hhautomatizacion/lavadora.net/README.md

<br/>
<p align="center">
  
</p>
<br/>

# Lavadora.Net

## Fecha
* 2014-03

## Descripcion del proyecto
* Control de lavadora industrial Tonello 420ls

## Herramientas utilizadas
* Visual Basic 2005
* KGL_WIN version 3.66

## Modelos de PLC, etc.
* PLC LS Master K 120S K7M-DR40U
* Modulo Analogo G7F-R2D 

## Autores
* <a href="http://www.github.com/pedrohermon">pedrohermon</a> 
* <a href="http://www.github.com/emmanuel156">emmanuel156</a> 

## Comentarios
* Ninguno

## Contenido
* Carpeta de Diagramas
	* Diagramas del proyecto
		* Diagramas electricos
		* Diagramas de bloques
		* Dibujos
* Carpeta de Documentos
	* Documentos pensados para el usuario final
		* Manuales de usuario
		* Manuales de programacion
* Carpeta de Fotos
	* Fotos del proyecto antes, durante y despues del desarrollo del mismo
		* Fotos
		* Capturas de pantalla
* Carpeta de Historial
	* Documentacion del desarrollo del proyecto
		* Hojas de datos de componentes
		* Manuales de usuario de componentes
		* Documentacion de funciones, herramientas
* Carpeta de Programas
	* Programas de Computadora, PLC, etc. 
		* Codigos fuente
		* Iconos e imagenes usados en los programas.
		* Archivos de configuracion de los programas
		* Programas compilados
* Carpeta de Pruebas
	* Pruebas preliminares del proyecto
		* Programas incompletos, o secciones de programas
		* Capturas de comunicacion
		* Modelos de componentes que se hayan probado

---
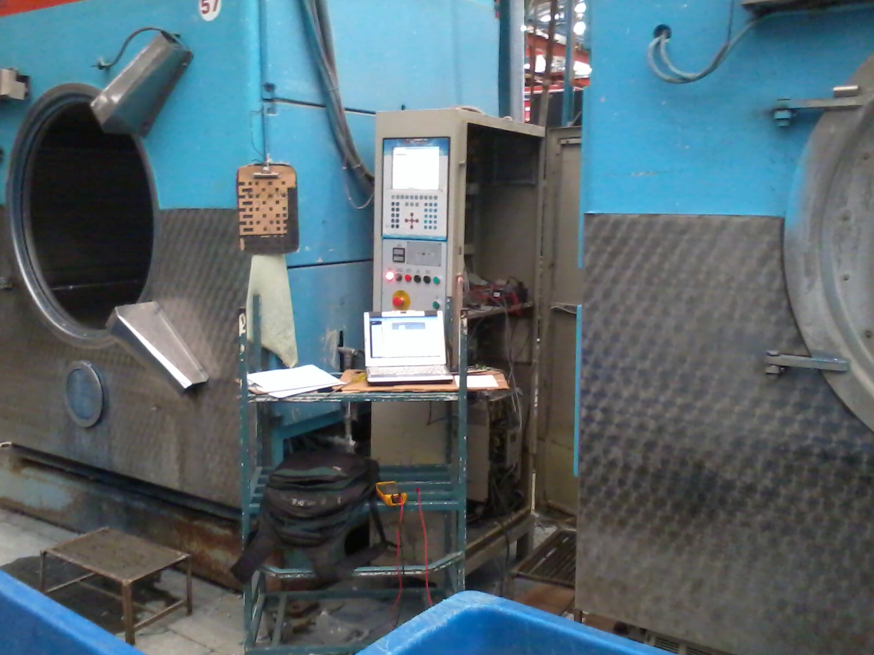
[picture p1: Fotos/2014-03-02 08.20.04.jpg]
2014-03-02 08.20.04.jpg

---
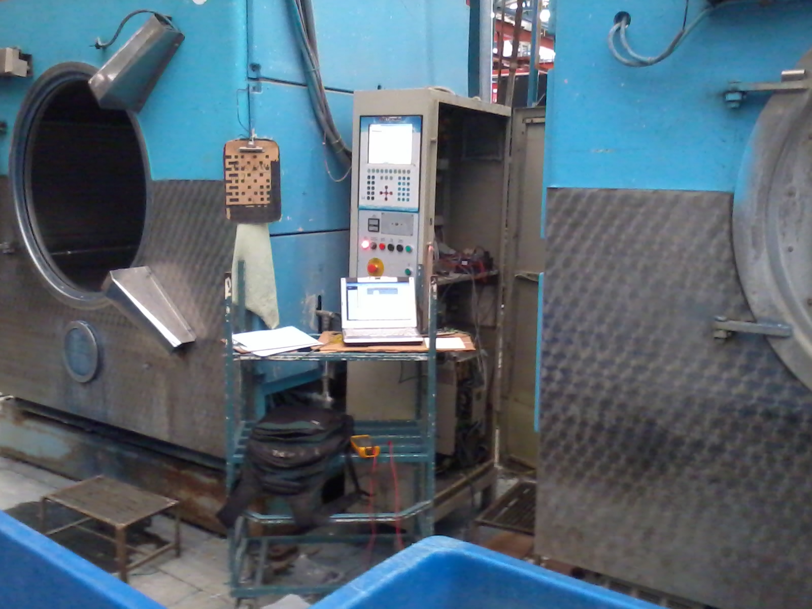
[picture p2: Fotos/2014-03-02 08.20.07.jpg]
2014-03-02 08.20.07.jpg

---
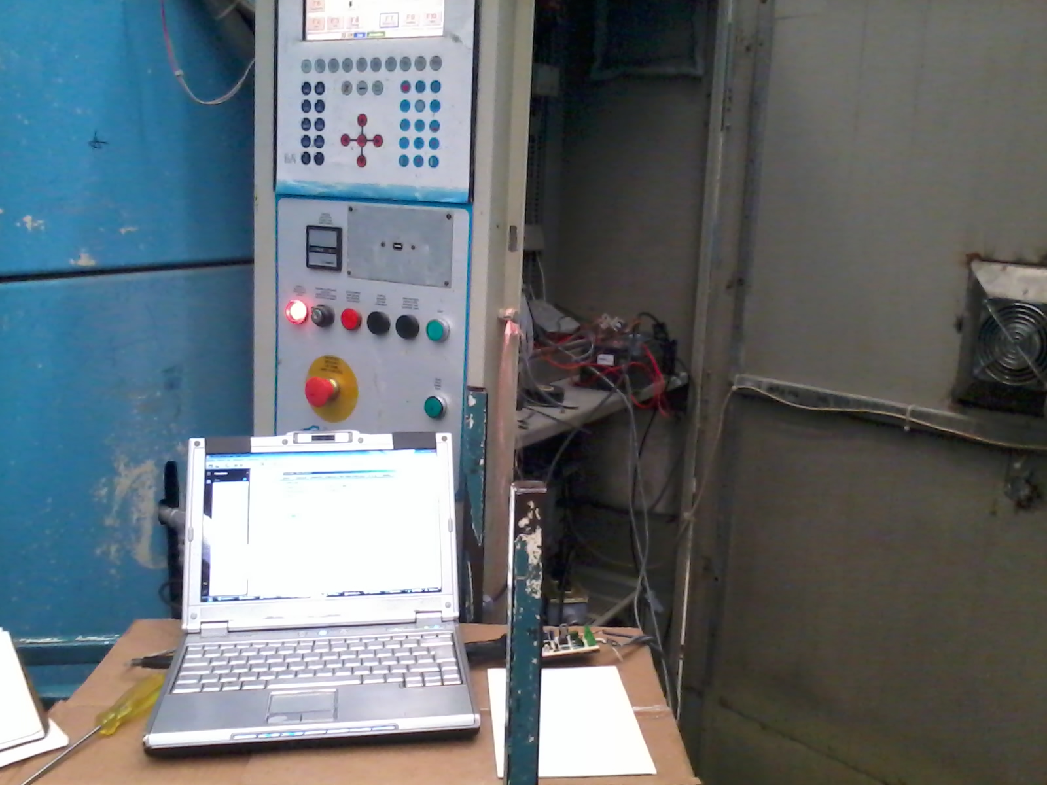
[picture p3: Fotos/2014-03-02 08.20.22.jpg]
2014-03-02 08.20.22.jpg

---
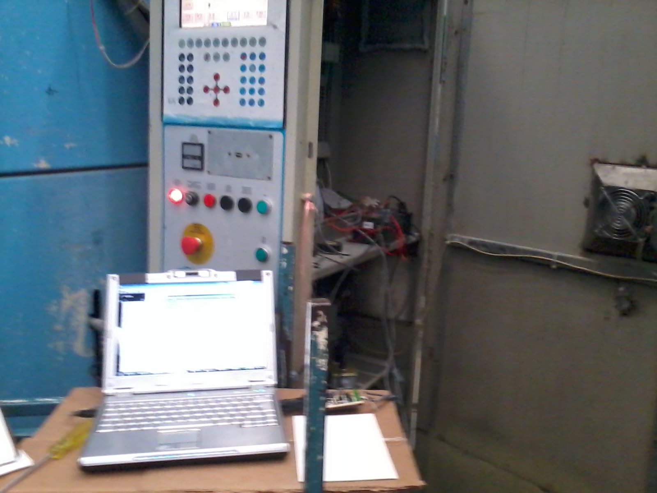
[picture p4: Fotos/2014-03-02 08.20.28.jpg]
2014-03-02 08.20.28.jpg

---
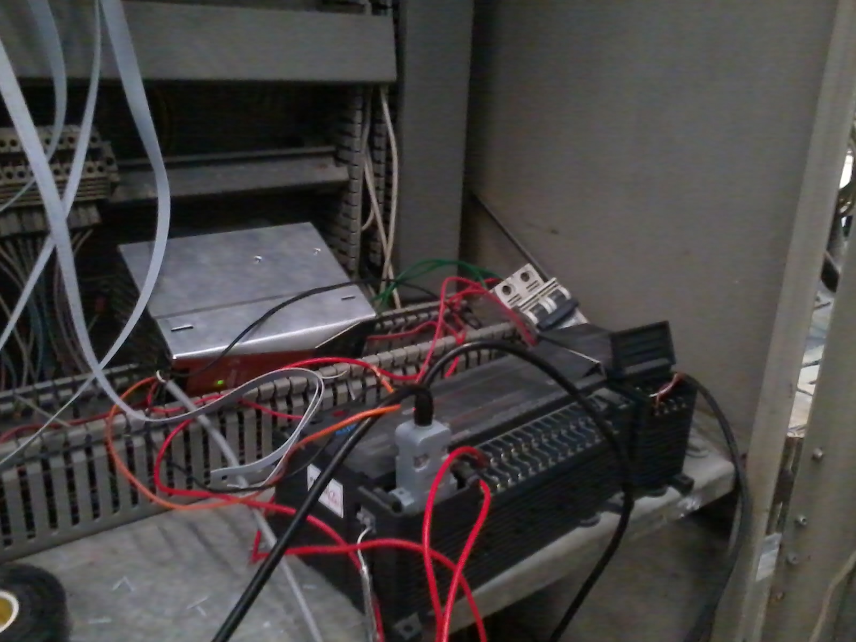
[picture p5: Fotos/2014-03-02 08.20.47.jpg]
2014-03-02 08.20.47.jpg

---
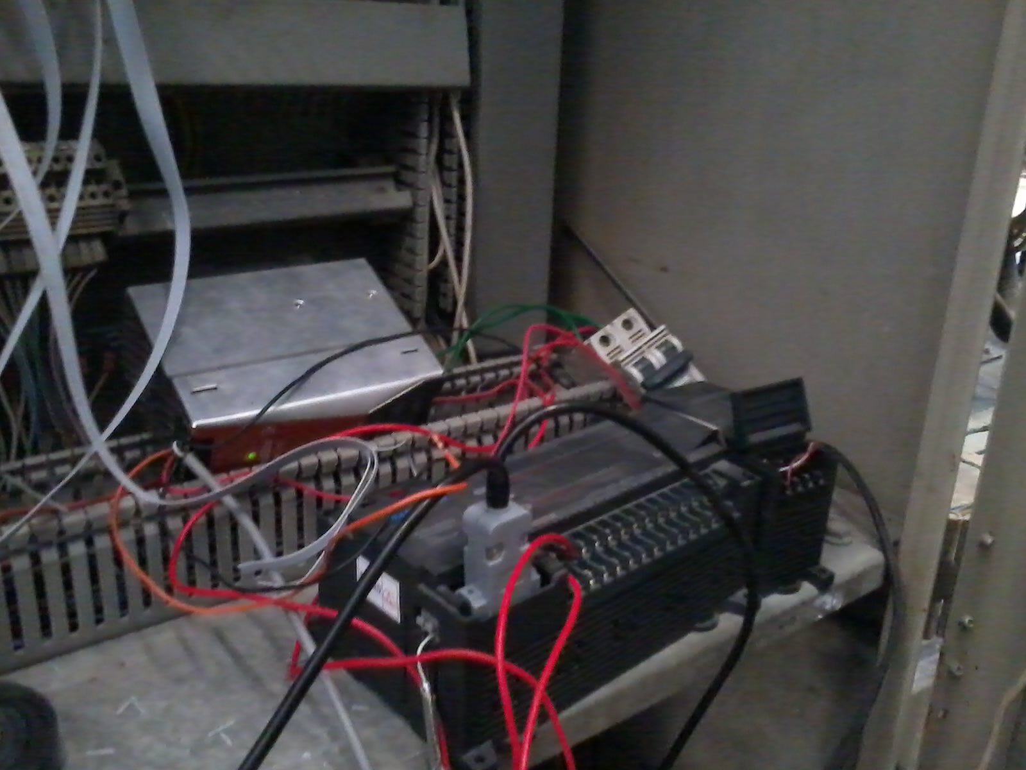
[picture p6: Fotos/2014-03-02 08.20.51.jpg]
2014-03-02 08.20.51.jpg

---
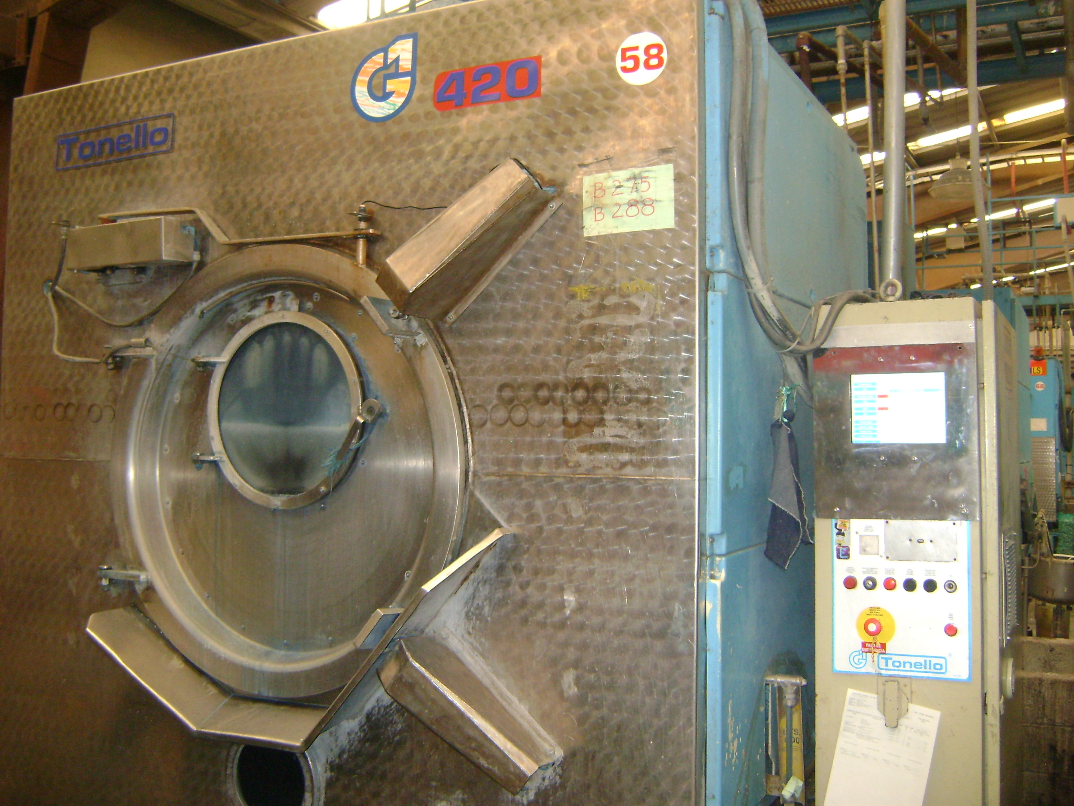
[picture p7: Fotos/DSC03446.JPG]

---
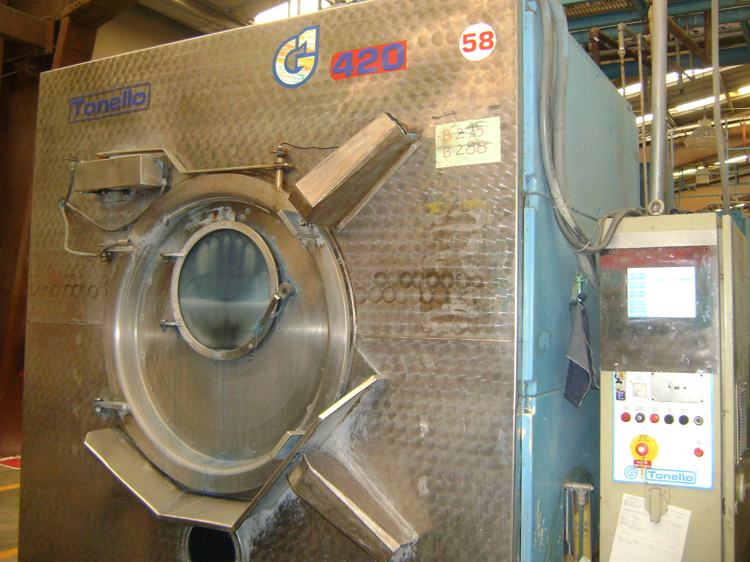
[picture p8: Fotos/DSC03447.JPG]

---
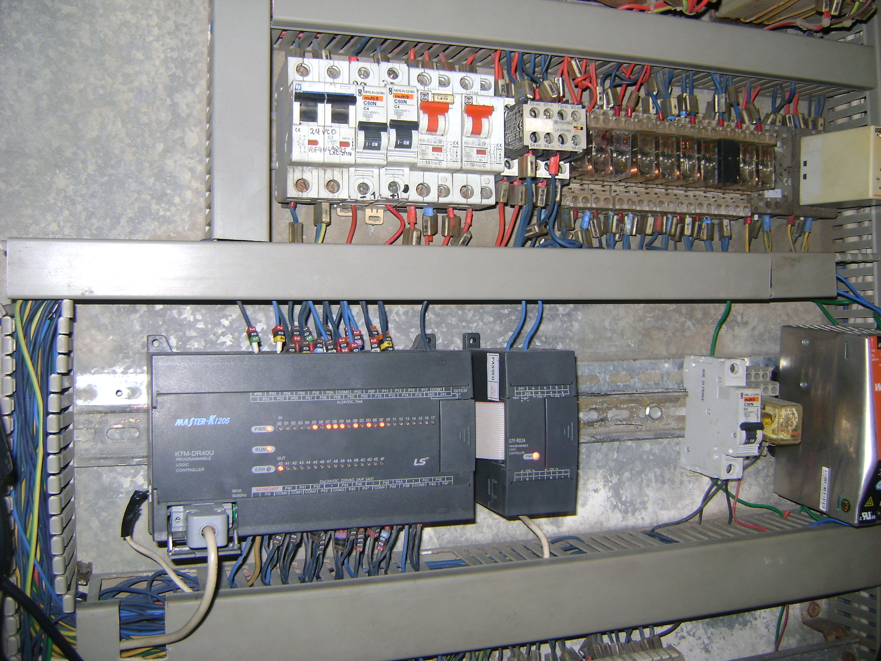
[picture p9: Fotos/DSC03448.JPG]

---
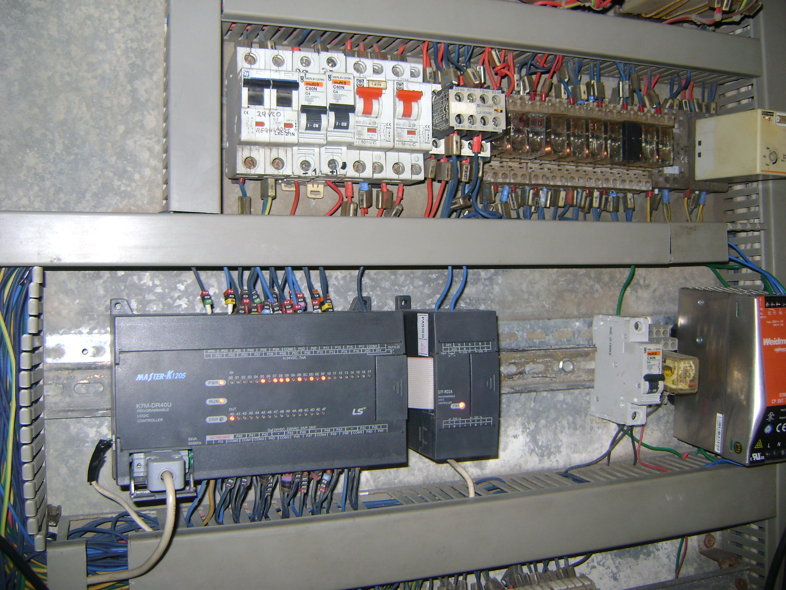
[picture p10: Fotos/DSC03449.JPG]

---
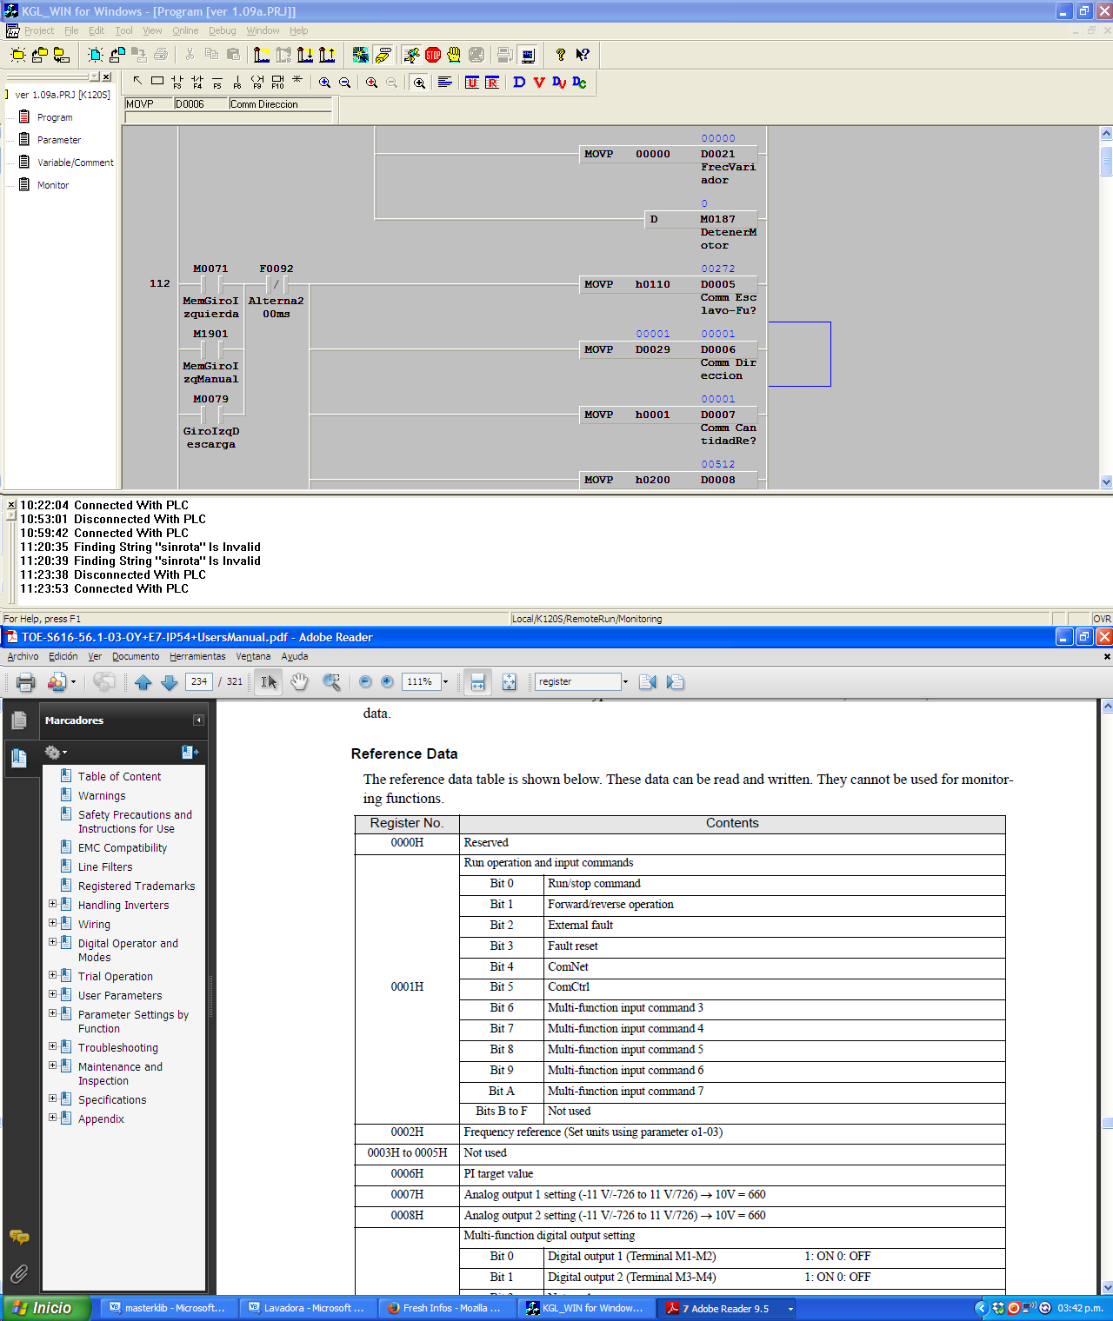
[picture p11: Historial/Captura de pantalla 2015-06-18 15.42.06.png]
Captura de pantalla 2015-06-18 15.42.06.png

---

---

---

---

---

---

---

---

---

---

---

---

---

---

---

---

---

---

---

---

---

---

---

---

---

---

---

---

---

---
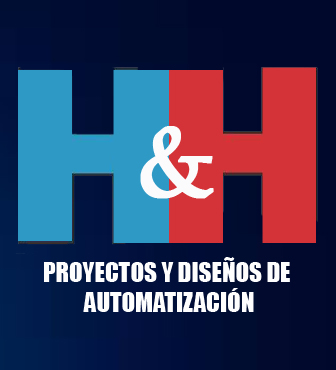
[picture p12: Programas/Lavadora/Iconos/logo.jpg]

---

---

---

---

---

---

---

---

---

---

---

---

---

---

---

---

---

---

---

---

---

---

---

---

---

---

---

---

---

---

---

---

---

---

---

---

---

---

---
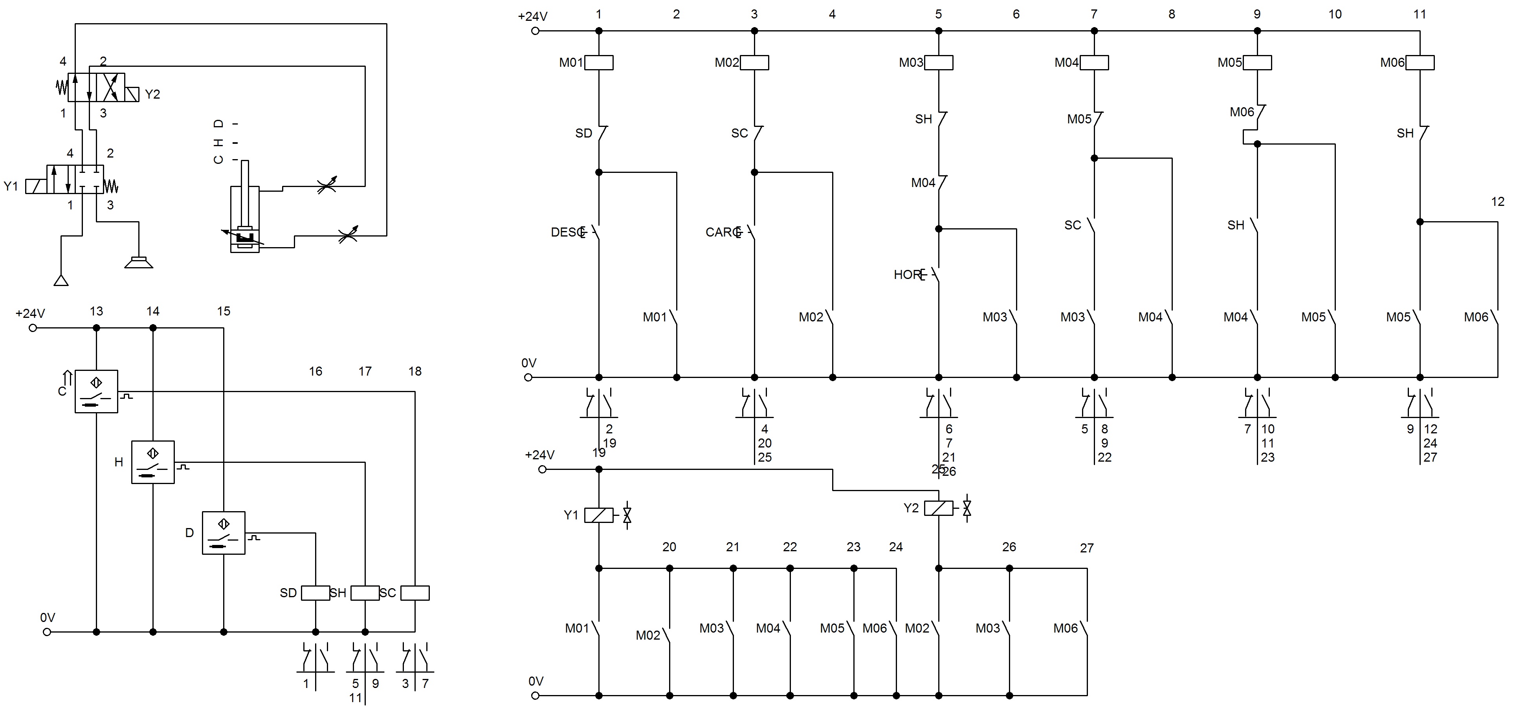
[picture p13: Pruebas/volqueteo.jpg]

---
