hhautomatizacion/lavadora.net/Documentos/Checklist.docx

# Checklist

Conexiones de PC

- Revisar conexión fuente de alimentación PC
- Revisar conexión fuente de alimentación Pantalla Touch
- Revisar cable de comunicación PC a PLC
- Revisar cable de conexión PC a Pantalla Touch

Conexiones de PLC

- Alimentación de 220v correctamente atornillada
- Sentido de giro de motor
- Revisar accionamiento final de carrera arriba
- Revisar accionamiento final de carrera horizontal
- Revisar accionamiento final de carrera abajo
- Revisar accionamiento Bomba Hidráulica
- Revisar accionamiento Pistón Desagüe
- Revisar accionamiento Válvula Agua fría
- Revisar accionamiento Válvula Agua caliente
- Revisar accionamiento Válvula Agua tratada
- Revisar accionamiento Válvula Vapor
- Revisar accionamiento Bomba cubeta de químicos

Programación PC

- Revisar activación de Windows
- Revisar arranque automático del programa
- Revisar parámetros de funcionamiento
- Revisar apagado automático al salir del programa
