hhautomatizacion/lavadora.net/Diagramas/entradas y salidas plc.xlsx

Entradas |  |  | Salidas
P00 | 205 | Cuentalitros * | P40 | 1001 | Start
P04 | 204 | Sensor cesto | P41 | 1003 | Desague
P05 | 101 | Paro de emergencia | P42 | 1004 | Agua fria
P06 | 102 | Start | P43 | 1005 | Agua caliente o tratada
P07 | 104 | Termico motor | P44 | 1006 | Agua zuavizada
P08 | 105 | Alarma inversor | P45 | 1007 | Vapor
P09 | 106 | Velocidad minima | P46 | 1008 | Abrir puerta
P0A | 107 | Puerta abierta | P47 | 2001 | Cerrar puerta
P0B | 108 | Puerta cerrada | P48 | 2002 | Seguros puerta
P0C | 202 | Sonda nivel medio | P49 | 2006 | Bajar maquina
P0D | 203 | Sonda nivel bajo | P4A | 3001 | Bomba cubeta
P0E | 206 | Maquina arriba | P4B | 3002 | Enjuague cubeta
P0F | 207 | Maquina horizontal | P4C | 3005 | Unidad hidraulica
P10 | 208 | Maquina abajo | P4D | 3006 | Torreta
P11 | 303 | Introducir quimicos
P12 | 304 | Enjuague quimicos
P13 | 307 | Nivel bajo quimicos
* Revisar que la conexión a tierra este aterizada en ambos extremos.
PLC | Variador
+ | 40
- | 41
