hhautomatizacion/lavadora.net/Programas/parametros.xlsx

Sheet: ton420ls
Registro | Descripcion | Valor
D750 | CentVel1Acel | 6000
D752 | CentVel2Acel | 12000
D754 | CentVel3Acel | 18000
D756 | CentVel4Acel | 21500
D760 | CentAcel1Acel | 1000
D762 | CentAcel2Acel | 500
D764 | CentAcel3Acel | 100
D766 | CentAcel4Acel | 50
D770 | CentVel1Freno | 21500
D772 | CentVel2Freno | 18000
D774 | CentVel3Freno | 12000
D776 | CentVel4Freno | 6000
D780 | CentAcel1Freno | 20
D782 | CentAcel2Freno | 150
D784 | CentAcel3Freno | 750
D786 | CentAcel4Freno | 1500
K100 | DeshabilitaVolquete | 1
 | RegistroControl | 0
 | RPMa60Hz | 50
 | FrecMaxima | 225
 | VelDescarga | 500
 | TiempoDescarga | 20
 | VelDespedrado | 400
 | AceleracionRotacion | 10
 | Multiplo | 10
 | Divisor | 1
 | OffsetLlenado | 2
 | NivelMinCalentamiento | 100
 | SopleteoSondas | 5
 | IntroAditivos | 10
 | EnjuagueAditivos | 5
 | DwelltimeVolquete | 1
 | MaximoTiempoVolquete | 60

Sheet: ton50ls
Registro | Descripcion | Valor
D750 | CentVel1Acel | 2000
D752 | CentVel2Acel | 4000
D754 | CentVel3Acel | 6000
D756 | CentVel4Acel | 8000
D760 | CentAcel1Acel | 10
D762 | CentAcel2Acel | 15
D764 | CentAcel3Acel | 10
D766 | CentAcel4Acel | 5
D770 | CentVel1Freno | 8000
D772 | CentVel2Freno | 6000
D774 | CentVel3Freno | 2000
D776 | CentVel4Freno | 1000
D780 | CentAcel1Freno | 10
D782 | CentAcel2Freno | 15
D784 | CentAcel3Freno | 10
D786 | CentAcel4Freno | 5
K100 | DeshabilitaVolquete | 1
 | RegistroControl | 0
 | RPMa60Hz | 300
 | FrecMaxima | 94
 | VelDescarga | 500
 | TiempoDescarga | 20
 | VelDespedrado | 400
 | AceleracionRotacion | 10
 | Multiplo | 1
 | Divisor | 1
 | OffsetLlenado | 2
 | NivelMinCalentamiento | 10
 | SopleteoSondas | 5
 | IntroAditivos | 10
 | EnjuagueAditivos | 5
 | DwelltimeVolquete | 1
 | MaximoTiempoVolquete | 60
