hhautomatizacion/lavadora.net/(list of files, cad)

Other CAD files:
Diagramas/Modificacion lavadora Tonello 420LS.dwg
Pruebas/simula-lavadora/simula lavadora.dwg
