hhautomatizacion/lavadora.net/Pruebas/README.md

<br/>
<p align="center">
  
</p>
<br/>

# Carpeta de Pruebas

## Pruebas preliminares del proyecto

* Programas incompletos, o secciones de programas

* Capturas de comunicacion

* Modelos de componentes que se hayan probado

---

---
