hhautomatizacion/lavadora.net/Pruebas/frecuencias 420ls.xlsx

Sheet: 20180418205009
2018-04-18T20:50:10.634213 | 1 | 3 | 2 | 1 | 92 | 185 | 237
2018-04-18T20:50:10.735077 | 1 | 3 | 2 | 1 | 92 | 185 | 237
2018-04-18T20:50:10.835950 | 1 | 3 | 2 | 1 | 92 | 185 | 237
2018-04-18T20:50:11.039070 | 1 | 3 | 2 | 1 | 94 | 56 | 44
2018-04-18T20:50:11.139814 | 1 | 3 | 2 | 1 | 94 | 56 | 44
2018-04-18T20:50:11.239197 | 1 | 3 | 2 | 1 | 95 | 249 | 236
2018-04-18T20:50:11.338816 | 1 | 3 | 2 | 1 | 95 | 249 | 236
2018-04-18T20:50:11.440816 | 1 | 3 | 2 | 1 | 94 | 56 | 44
2018-04-18T20:50:11.843694 | 1 | 3 | 2 | 1 | 92 | 185 | 237
2018-04-18T20:50:11.945697 | 1 | 3 | 2 | 1 | 92 | 185 | 237
2018-04-18T20:50:12.045073 | 1 | 3 | 2 | 1 | 90 | 57 | 239
2018-04-18T20:50:12.145820 | 1 | 3 | 2 | 1 | 91 | 248 | 47
2018-04-18T20:50:12.449318 | 1 | 3 | 2 | 1 | 92 | 185 | 237
2018-04-18T20:50:12.549942 | 1 | 3 | 2 | 1 | 94 | 56 | 44
2018-04-18T20:50:12.649566 | 1 | 3 | 2 | 1 | 93 | 120 | 45
2018-04-18T20:50:12.749066 | 1 | 3 | 2 | 1 | 94 | 56 | 44
2018-04-18T20:50:12.851239 | 1 | 3 | 2 | 1 | 96 | 185 | 252
2018-04-18T20:50:13.054317 | 1 | 3 | 2 | 1 | 95 | 249 | 236
2018-04-18T20:50:13.153948 | 1 | 3 | 2 | 1 | 95 | 249 | 236
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
