hhautomatizacion/lavadora.net/Pruebas/frecuencias 420mj2.xlsx

Sheet: 20180418024331
2018-04-18T02:43:32.126823 | 1 | 3 | 2 | 0 | 0 | 184 | 68
2018-04-18T02:43:32.832956 | 1 | 3 | 2 | 0 | 0 | 184 | 68
2018-04-18T02:43:33.539447 | 1 | 3 | 2 | 0 | 0 | 184 | 68
2018-04-18T02:43:34.245954 | 1 | 3 | 2 | 0 | 0 | 184 | 68
2018-04-18T02:43:34.952448 | 1 | 3 | 2 | 0 | 0 | 184 | 68
2018-04-18T02:43:35.661078 | 1 | 3 | 2 | 0 | 0 | 184 | 68
2018-04-18T02:43:36.368016 | 1 | 3 | 2 | 0 | 0 | 184 | 68
2018-04-18T02:43:37.074031 | 1 | 3 | 2 | 0 | 0 | 184 | 68
2018-04-18T02:43:37.781709 | 1 | 3 | 2 | 0 | 0 | 184 | 68
2018-04-18T02:43:38.488210 | 1 | 3 | 2 | 0 | 0 | 184 | 68
2018-04-18T02:43:39.194606 | 1 | 3 | 2 | 0 | 0 | 184 | 68
2018-04-18T02:43:39.901587 | 1 | 3 | 2 | 0 | 0 | 184 | 68
2018-04-18T02:43:40.608093 | 1 | 3 | 2 | 0 | 0 | 184 | 68
2018-04-18T02:43:41.314462 | 1 | 3 | 2 | 0 | 0 | 184 | 68
2018-04-18T02:43:42.020457 | 1 | 3 | 2 | 0 | 0 | 184 | 68
2018-04-18T02:43:42.727586 | 1 | 3 | 2 | 0 | 0 | 184 | 68
2018-04-18T02:43:43.432619 | 1 | 3 | 2 | 0 | 0 | 184 | 68
2018-04-18T02:43:44.138985 | 1 | 3 | 2 | 0 | 0 | 184 | 68
2018-04-18T02:43:44.845087 | 1 | 3 | 2 | 0 | 0 | 184 | 68
2018-04-18T02:43:45.550836 | 1 | 3 | 2 | 0 | 0 | 184 | 68
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
