hhautomatizacion/lavadora.net/Pruebas/frecuencias 50ls.xlsx

Sheet: 20190417140326
2019-04-17T14:03:26.694000 | 1 | 3 | 2 | 0 | 0 | 184 | 68
2019-04-17T14:03:26.804000 | 1 | 3 | 2 | 0 | 0 | 184 | 68
2019-04-17T14:03:27.119000 | 1 | 3 | 2 | 0 | 0 | 184 | 68
2019-04-17T14:03:27.463000 | 1 | 3 | 2 | 0 | 0 | 184 | 68
2019-04-17T14:03:28.010000 | 1 | 3 | 2 | 0 | 0 | 184 | 68
2019-04-17T14:03:28.338000 | 1 | 3 | 2 | 0 | 0 | 184 | 68
2019-04-17T14:03:28.775000 | 1 | 3 | 2 | 0 | 0 | 184 | 68
2019-04-17T14:03:29.103000 | 1 | 3 | 2 | 0 | 0 | 184 | 68
2019-04-17T14:03:29.322000 | 1 | 3 | 2 | 0 | 0 | 184 | 68
2019-04-17T14:03:29.650000 | 1 | 3 | 2 | 0 | 0 | 184 | 68
2019-04-17T14:03:29.978000 | 1 | 3 | 2 | 0 | 0 | 184 | 68
2019-04-17T14:03:30.307000 | 1 | 3 | 2 | 0 | 0 | 184 | 68
2019-04-17T14:03:30.525000 | 1 | 3 | 2 | 0 | 0 | 184 | 68
2019-04-17T14:03:31.182000 | 1 | 3 | 2 | 0 | 0 | 184 | 68
2019-04-17T14:03:31.510000 | 1 | 3 | 2 | 0 | 0 | 184 | 68
2019-04-17T14:03:31.838000 | 1 | 3 | 2 | 0 | 0 | 184 | 68
2019-04-17T14:03:31.947000 | 1 | 3 | 2 | 0 | 0 | 184 | 68
2019-04-17T14:03:32.057000 | 1 | 3 | 2 | 0 | 0 | 184 | 68
2019-04-17T14:03:32.385000 | 1 | 3 | 2 | 0 | 0 | 184 | 68
2019-04-17T14:03:32.603000 | 1 | 3 | 2 | 0 | 0 | 184 | 68
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
