hhautomatizacion/lavadora.net/Pruebas/simula-lavadora/simula lavadora.pdf

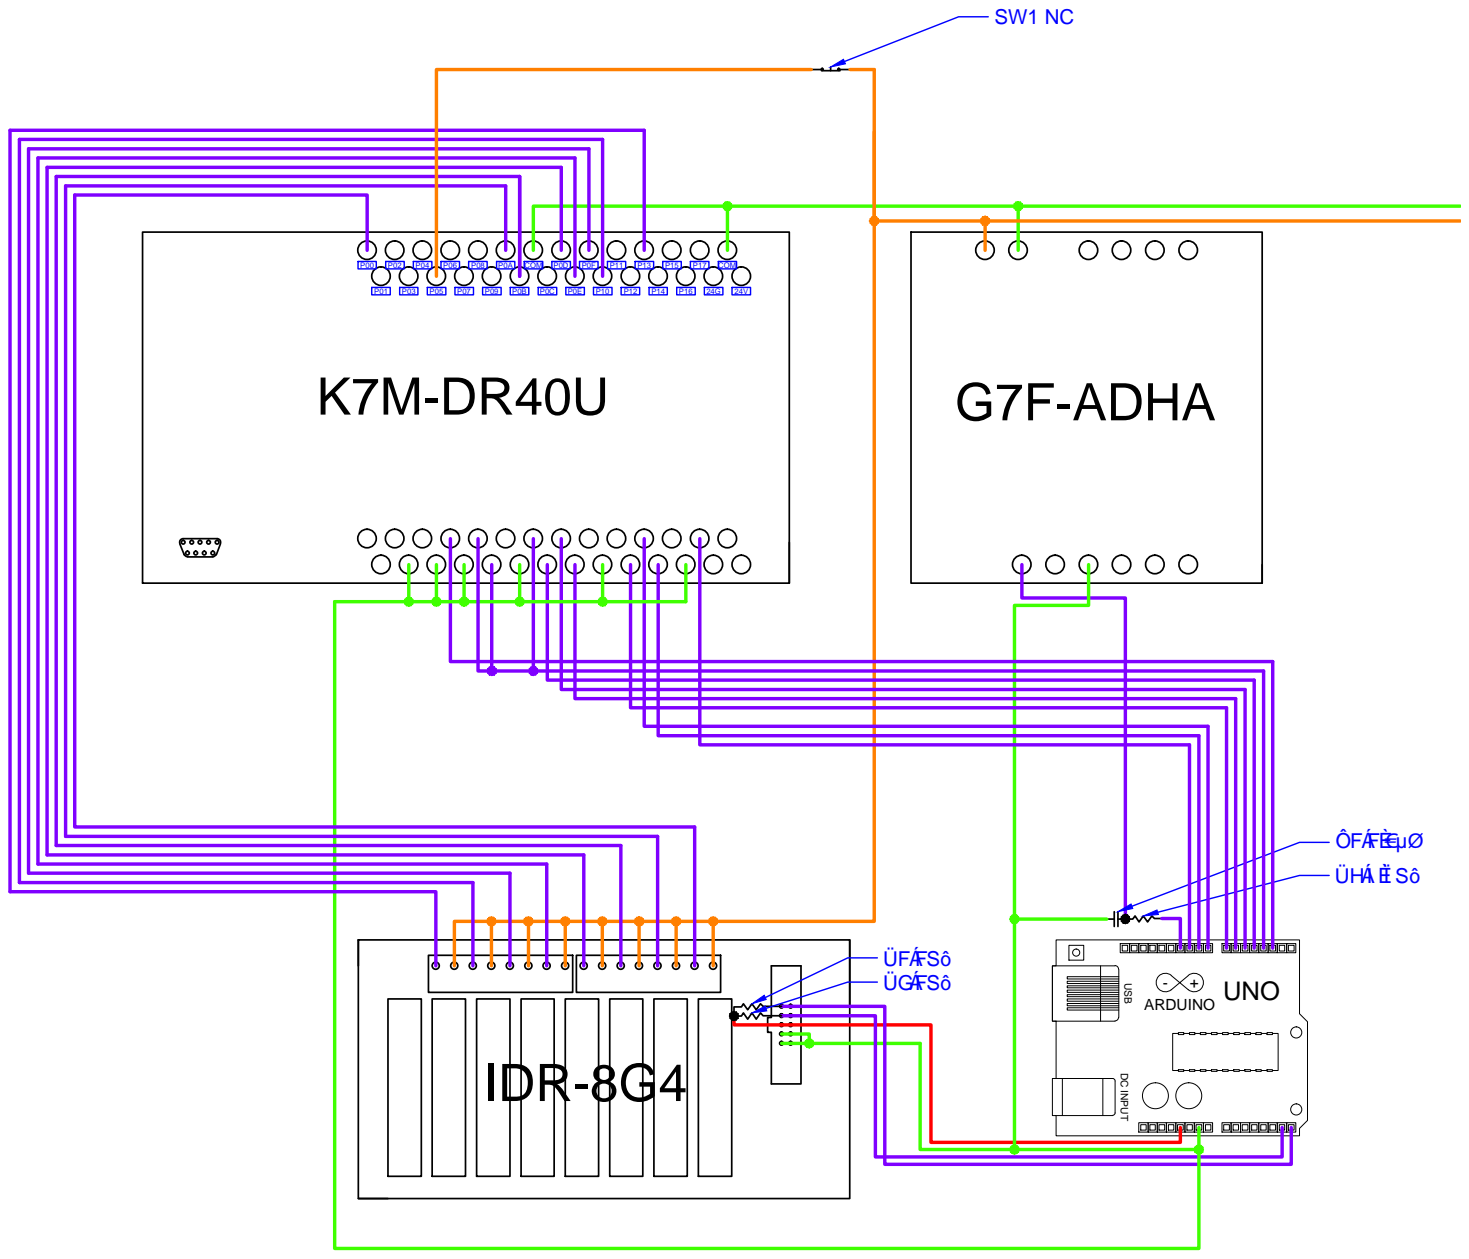
[picture p28: page 1]

USB DC INPUT UNO ARDUINO - + 5. 5.
