hhautomatizacion/lavadora.net/Diagramas/Diagrama Modificacion Lavadora Tonello 420ls.pdf

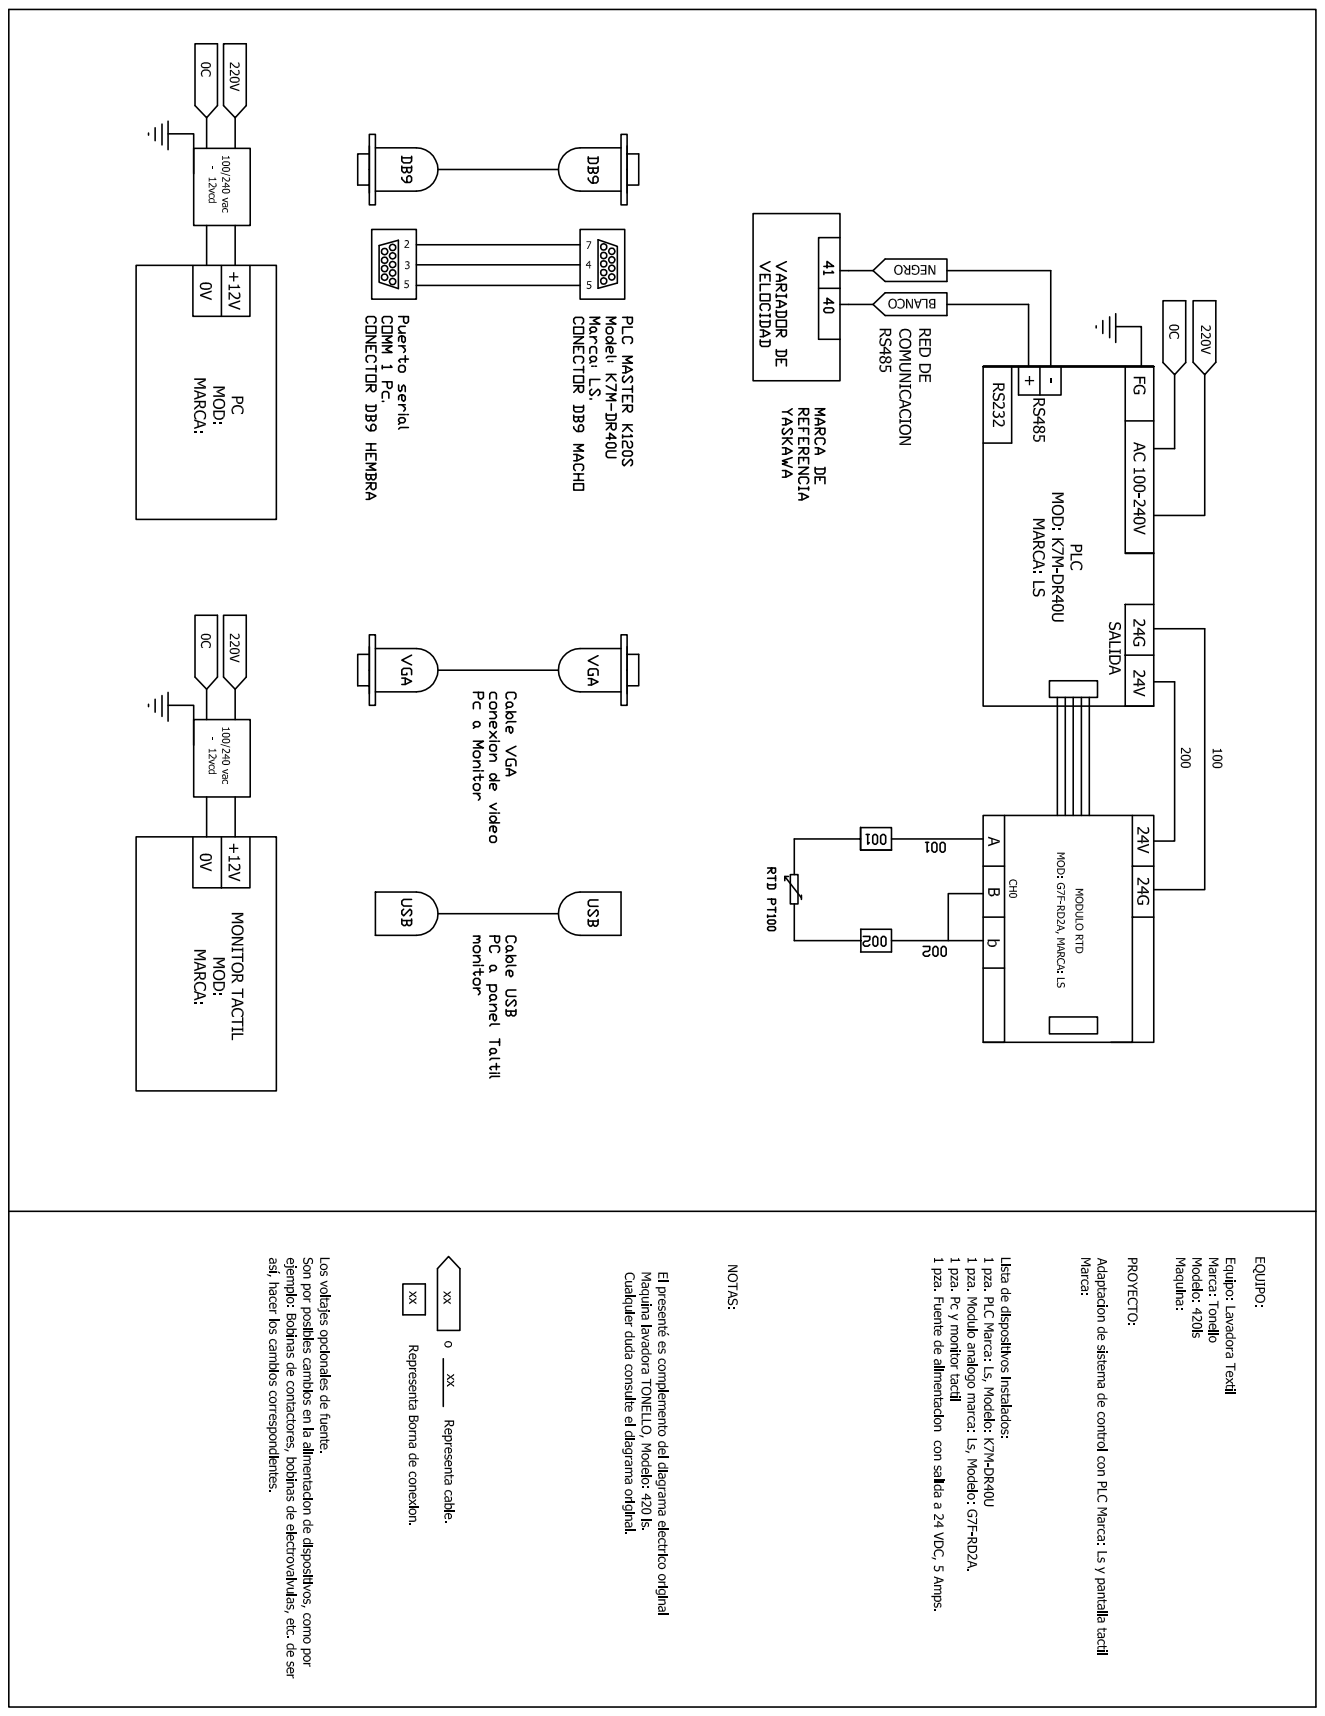
[picture p29: page 1]

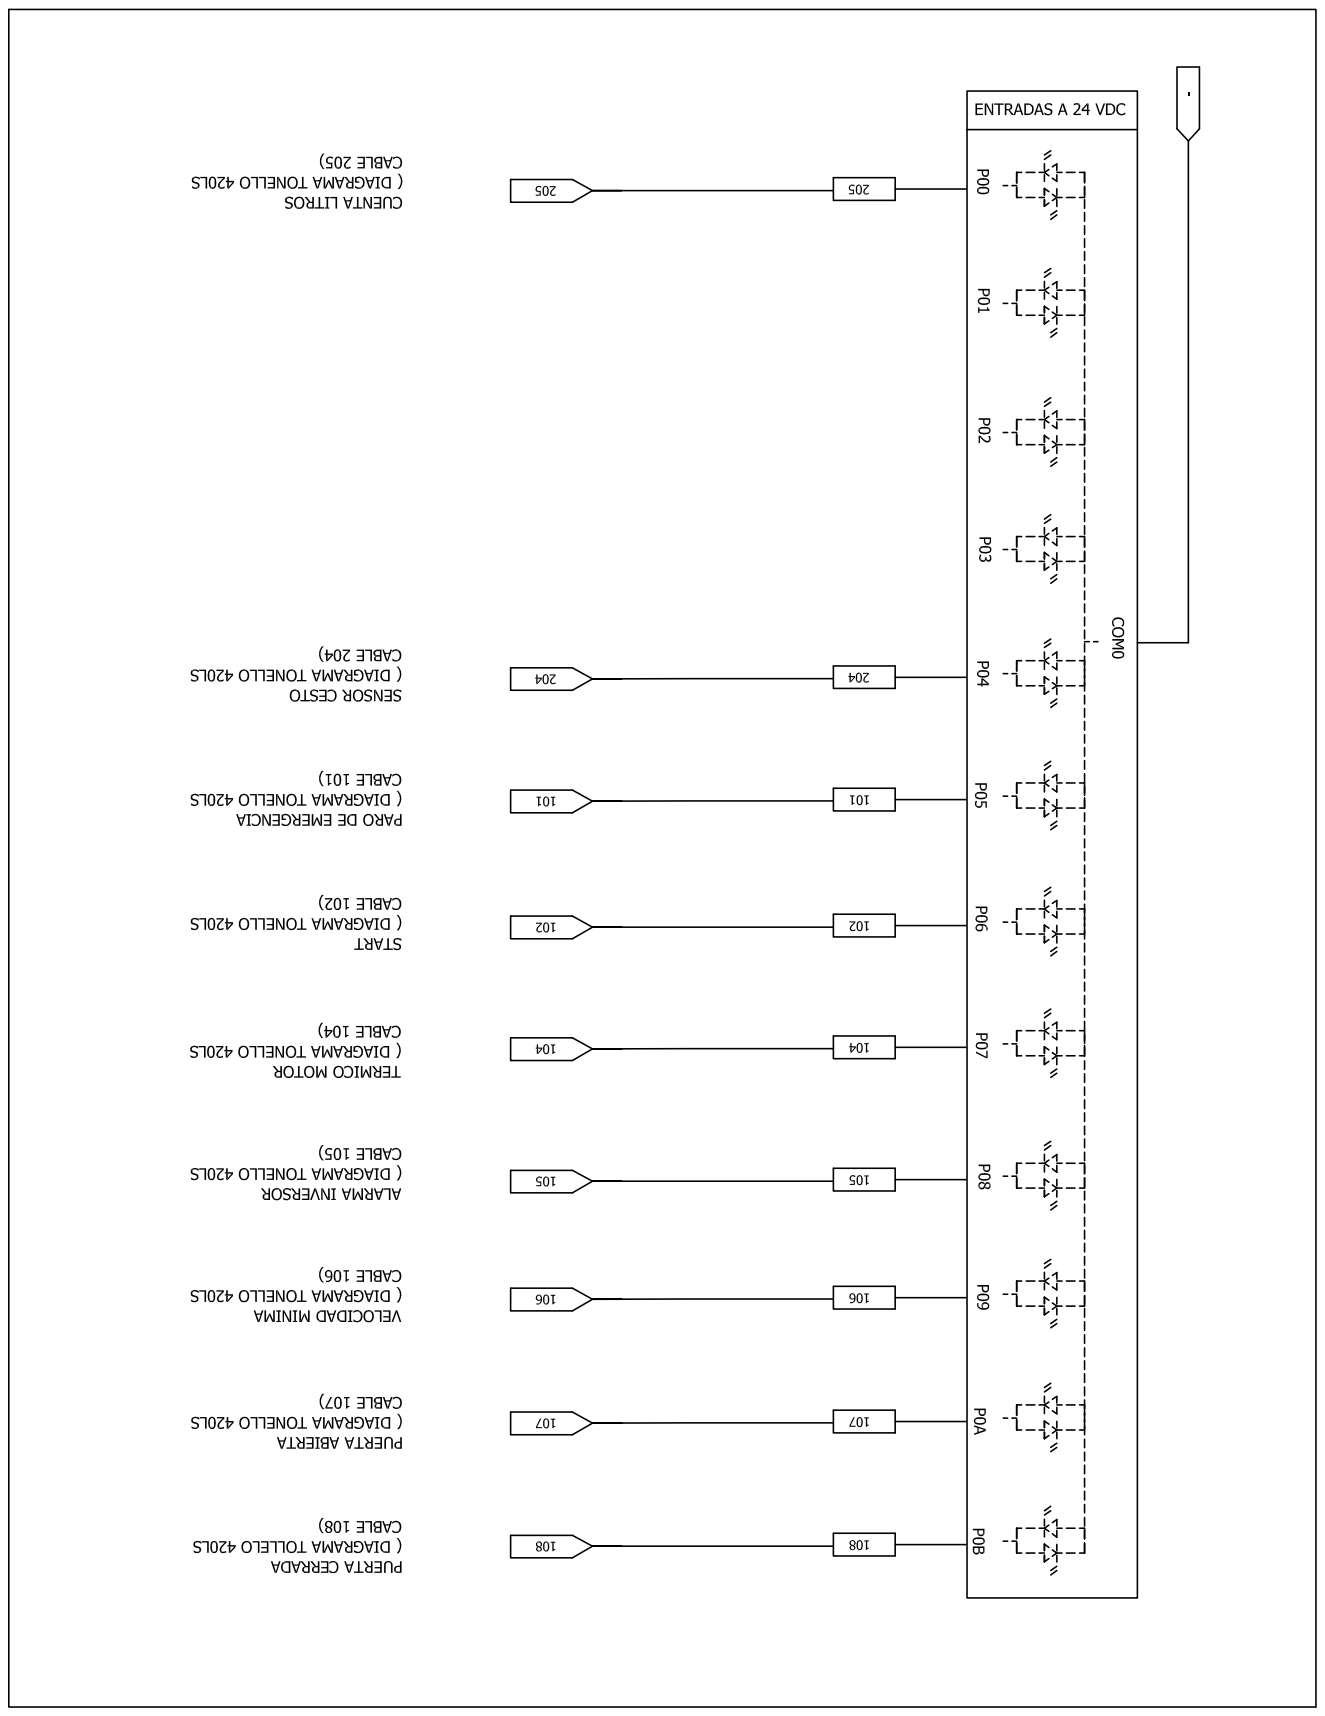
[picture p30: page 2]

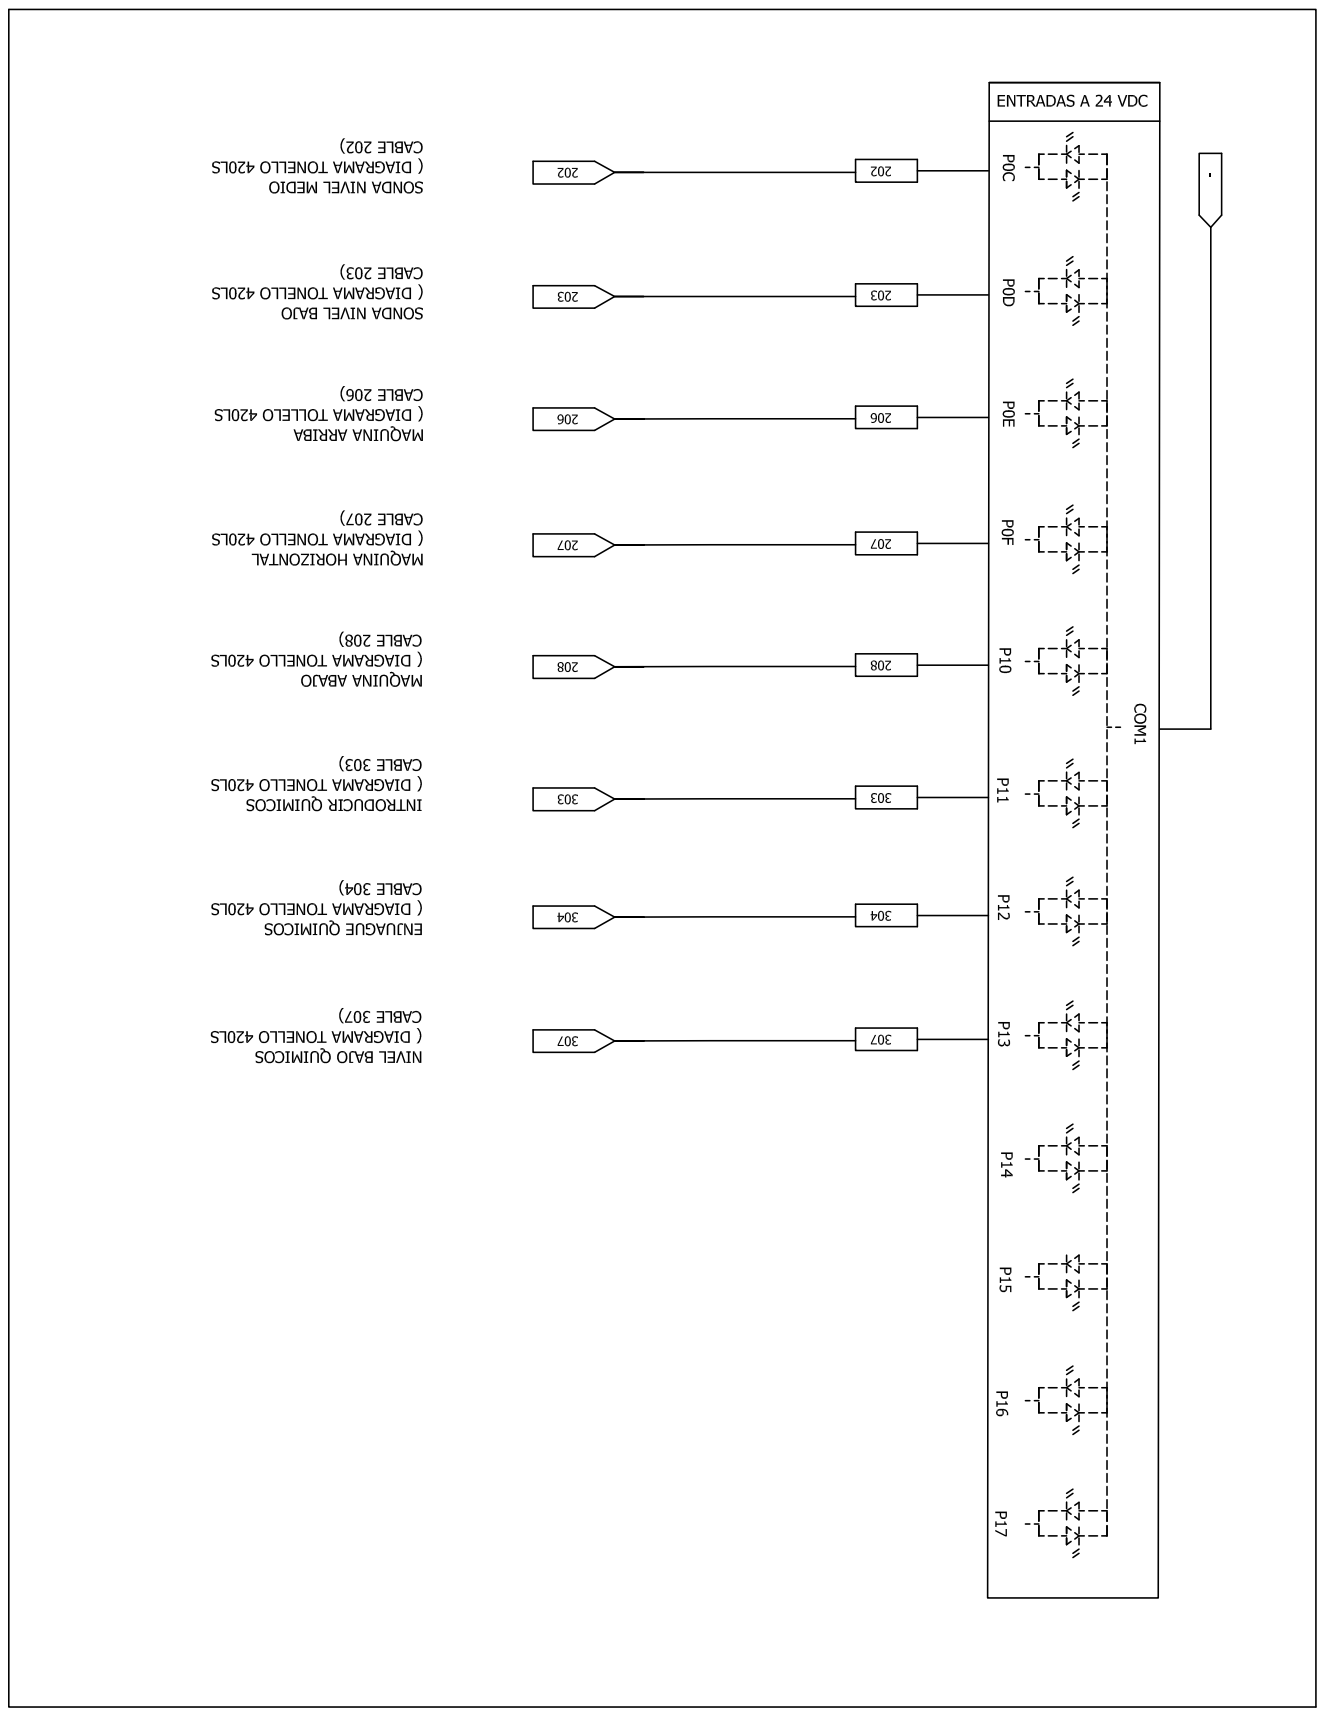
[picture p31: page 3]

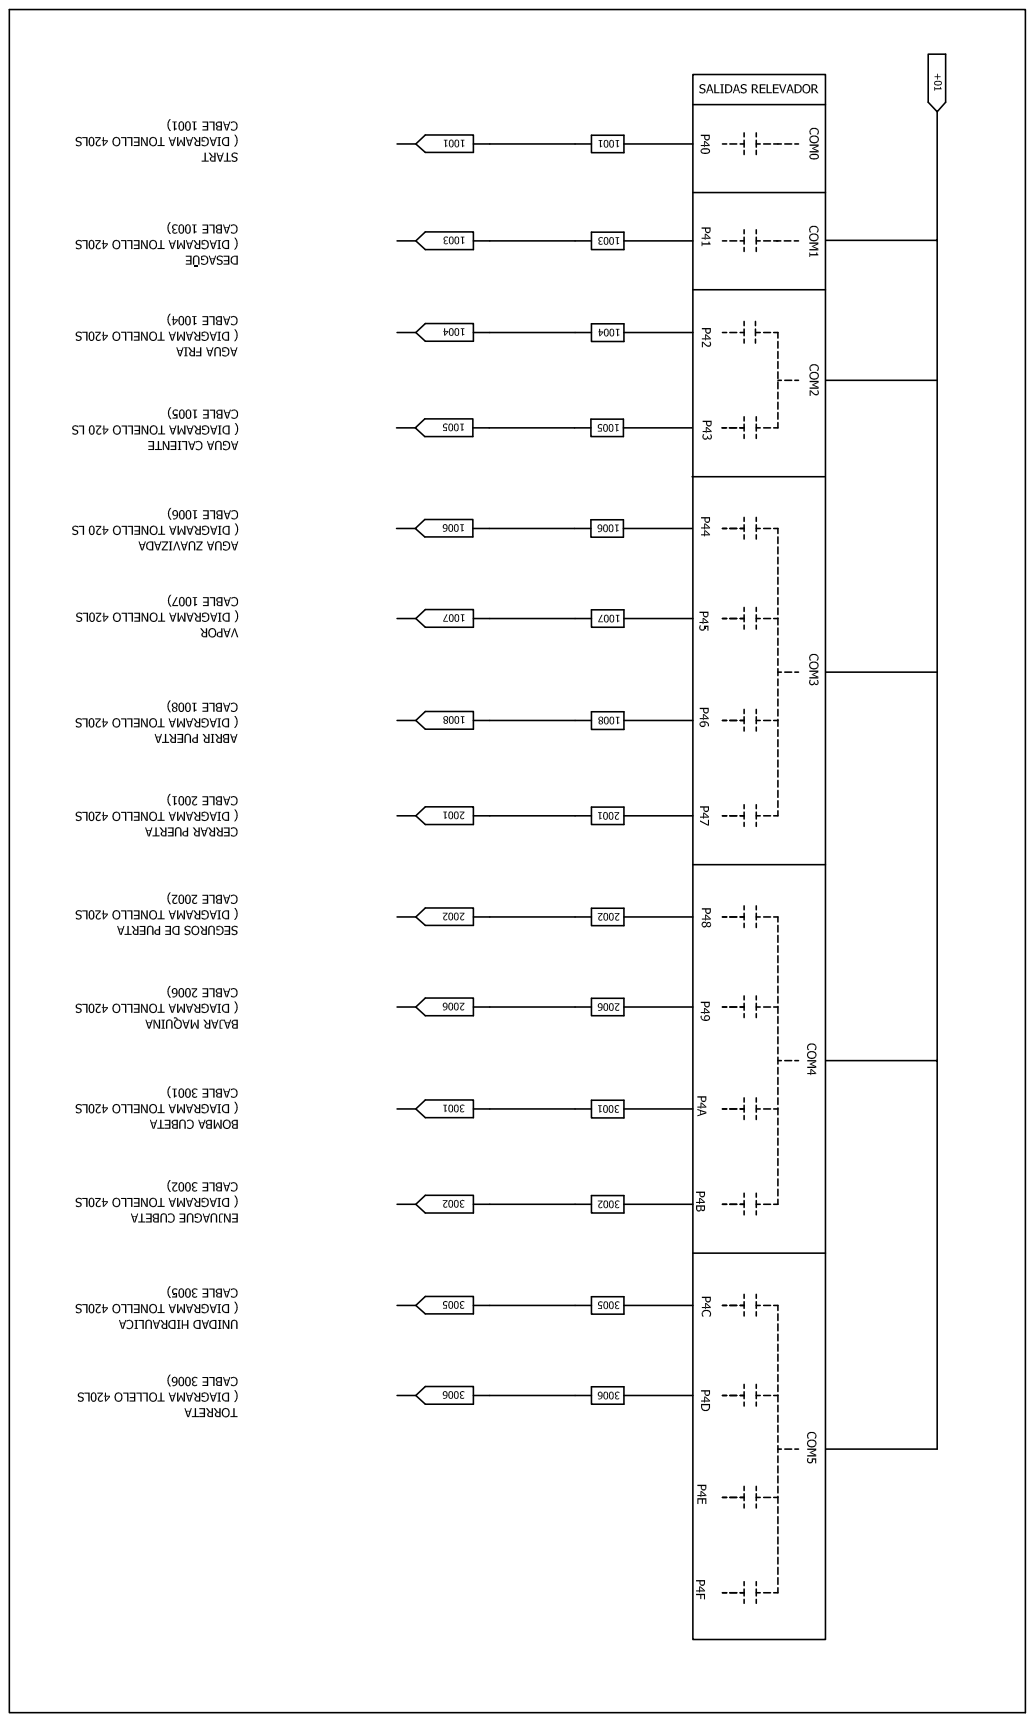
[picture p32: page 4]
