hhautomatizacion/lavadora.net/(commit log)

2015-10-29 Commit inicial
    [Libro2.xlsx, calculo freq centrifugado.xlsx, entradas y salidas plc.xlsx, estructura paso.xlsx, parametros comunicacion variador.xlsx]
2015-10-29 Previsualizacion de fotos.
2015-11-04 Se agregan preview de fotos
2016-03-31 Se actualiza archivo parametros comunicacion variador.xlsx
    [parametros comunicacion variador.xlsx]
2016-11-23 Modifica nota.
    [entradas y salidas plc.xlsx]
2016-11-28 Version beta liberada.
    [estructura paso.xlsx, parametros comunicacion variador.xlsx, simula lavadora.dwg]
2016-11-29 Diagrama de modificacion lavadora Tonello,modelo 420ls
    [Modificacion lavadora Tonello 420LS.dwg]
2016-12-05 Se resetea numero de version a 1.00 para PLC y 1.0.0 para PC Se implementa #2, #8, #10 y #12
2017-01-09 Se agrega manual de usuario.
2017-02-08 Se corrige error no carga correctamente la receta (valores arriba de 255) Se agrega mostrar texto en los botones.
    [entradas y salidas plc.xlsx, simula lavadora.dwg]
2017-02-17 correccion de error en modulo de salidas ( Salida P40 )
    [Modificacion lavadora Tonello 420LS.dwg]
2017-03-16 Actualizacion diagrama marzo 2017
    [Modificacion lavadora Tonello 420LS.dwg]
2017-03-16 Actualizacion agua zuavizada marzo 2017
    [Modificacion lavadora Tonello 420LS.dwg]
2017-03-16 Actualizacion agua tratada.
    [entradas y salidas plc.xlsx]
2017-05-15 Se corrije diagrama simula lavadora. (El desague no va en P40 sino en P41)
    [simula lavadora.dwg]
2019-01-07 Se corrige detalle de fuente en diagrama Modificacion lavadora Tonello 420LS.Se anexa diagrama modificacion lavadora tonello 50ls.
    [Modificacion lavadora Tonello 420LS.dwg]
2019-04-25 Se libera version 1.1.0 de PC y 1.03 de PLC
    [Libro2.xlsx, Modificacion lavadora Tonello 420LS.dwg, calculo freq centrifugado.xlsx, estructura paso.xlsx, frecuencias 420ls.xlsx, frecuencias 420mj2.xlsx, frecuencias 50ls.xlsx, parametros comunicacion variador.xlsx]
2019-05-27 Se libera version 1.2.0 de PC y 1.03 de PLC
2020-02-06 Se libera version 1.2.0
    [parametros.xlsx]
2022-10-01 Se actualiza a version de Visual Studio 2022 Se agrega sistema de niveles de autorizacion (passwords)
2022-10-11 Ya no se ocupa memoria de PLC al edtar receta
2022-11-03 * Se unifican colores de controles * Se agrega paso Jet en automatico
    [estructura paso.xlsx]
2022-11-14 * Se libera version 1.04 de PLC y 1.3.0 de PC
    [estructura paso.xlsx]
